MagpieModular/Dodeca/README.md

# Dodeca
An Open Hardware, DIY Eurorack extensible platform allowing the configuration of custom MIDI outputs.

The Dodeca can be chained together with other Dodeca boards. The
typical configuration is the Dubldeca, which is two Dodeca boards
configured in a left and right arrangement, as used by the
[Octatrack 2x Setup Firmware](Octatrack 2x Setup).

# PCBs and panels

Available from Magpie Modular:
- [Dodeca PCB](https://magpie-modular.myshopify.com/products/dodeca)
- [Dubldeca PCBs](https://magpie-modular.myshopify.com/products/dodecca-dubldeca-pcbs)
- [Dubldeca Panel](https://magpie-modular.myshopify.com/products/magpie-modular-dubledeca)

# Build resources

This repository contains the [Build Guide](Build Guide/Build Guide.pdf) and [Hardware Resources](Hardware)

Components for the Dodeca can be ordered from Mouser using [this cart](https://ca.mouser.com/ProjectManager/ProjectDetail.aspx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)

There is also a [Muffwiggler Build Thread](https://www.muffwiggler.com/forum/viewtopic.php?t=188619&highlight=).
