MagpieModular/Dodeca/DODECA_MOUSER_BOM.xlsx

DODECA
Mouser # | Mfr. # | Alternate | Qty. |  | Package | Description |  | Price (USD) | Ext.: (USD) | Links
512-BAT54S | BAT54S |  | 1 | BAT54S | SOT-23 | Schottky Diodes & Rectifiers 30V 200mA | Product Page (http://www.mouser.com/Search/ProductDetail.aspx?R=512-BAT54S) | $0.20 | $0.20
859-6N137 | 6N137 |  | 1 | 6N137 | DIP-8 | High Speed Optocouplers High Speed 10MBd LogicGate Output | Product Page (http://www.mouser.com/Search/ProductDetail.aspx?R=859-6N137) | $0.49 | $0.49
595-TL074IDR | TL074IDR |  | 3 | TL074 | SOIC-14 | Operational Amplifiers - Op Amps Quad Low-Noise JFET-Input | Product Page (http://www.mouser.com/Search/ProductDetail.aspx?R=595-TL074IDR) | $0.82 | $2.46
512-MB1S | MB1S |  | 1 | MB1S | SOIC-4 | Bridge Rectifiers 0.5A Bridge | Product Page (http://www.mouser.com/Search/ProductDetail.aspx?R=512-MB1S) | $0.38 | $0.38
71-CRCW0805-220-E3 | CRCW0805220RFKEA | 603-RC0805FR-07220RL | 1 | 220R | 0805 SMD | Thick Film Resistors - SMD 1/8watt 220ohms 1% 100ppm | Product Page (http://www.mouser.com/Search/ProductDetail.aspx?R=71-CRCW0805-220-E3) | $0.10 | $0.10
660-RK73H2ATTD1692F | RK73H2ATTD1692F |  | 3 | 16.9K | 0805 SMD | Thick Film Resistors - SMD 1/4W 16.9K OHM 1% | Product Page (http://www.mouser.com/Search/ProductDetail.aspx?R=660-RK73H2ATTD1692F) | $0.11 | $0.33
660-RK73H2ATTD2002F | RK73H2ATTD2002F | 603-RC0805FR-0720KL | 9 | 20K | 0805 SMD | Thick Film Resistors - SMD 1/4watts 20Kohms 1% | Product Page (http://www.mouser.com/Search/ProductDetail.aspx?R=660-RK73H2ATTD2002F) | $0.11 | $0.99
603-RC0805FR-0710KL | RC0805FR-0710KL |  | 25 | 10K | 0805 SMD | Thick Film Resistors - SMD 10K OHM 1% | Product Page (http://www.mouser.com/Search/ProductDetail.aspx?R=603-RC0805FR-0710KL) | $0.02 | $0.40
603-RC0805FR-071KL | RC0805FR-071KL |  | 12 | 1K | 0805 SMD | Thick Film Resistors - SMD 1K OHM 1% | Product Page (http://www.mouser.com/Search/ProductDetail.aspx?R=603-RC0805FR-071KL) | $0.02 | $0.19
652-3296W-1-502LF | 3296W-1-502LF | 81-PV36W502C01B00 | 3 | 5K trimmer | 0805 SMD | Trimmer Resistors - Through Hole 3/8" 5Kohms Sealed Vertical Adjust | Product Page (http://www.mouser.com/Search/ProductDetail.aspx?R=652-3296W-1-502LF) | $2.41 | $7.23
581-0805YA471KAT2A | 0805YA471KAT2A |  | 12 | 470pF | 0805 SMD | Multilayer Ceramic Capacitors MLCC - SMD/SMT 16V 470pF C0G 0805 10% Tol | Product Page (http://www.mouser.com/Search/ProductDetail.aspx?R=581-0805YA471KAT2A) | $0.08 | $0.96
81-GRM40X103K50D | GRM216R71H103KA01D |  | 11 | 10nF / 0.01uF | 0805 SMD | Multilayer Ceramic Capacitors MLCC - SMD/SMT 0805 0.01uF 50volts X7R 10% | Product Page (http://www.mouser.com/Search/ProductDetail.aspx?R=81-GRM40X103K50D) | $0.02 | $0.18
81-GRM40X104K50L | GRM21BR71H104KA01L |  | 7 | 100nF / 0.1uF | 0805 SMD | Multilayer Ceramic Capacitors MLCC - SMD/SMT 0805 0.1uF 50volts X7R 10% | Product Page (http://www.mouser.com/Search/ProductDetail.aspx?R=81-GRM40X104K50L) | $0.17 | $1.19
647-ULD1V470MED1TD | ULD1V470MED1TD |  | 3 | 47uF Electrolytic | Radial | Aluminum Electrolytic Capacitors - Leaded 35V 47UF 20% | Product Page (http://www.mouser.com/Search/ProductDetail.aspx?R=647-ULD1V470MED1TD) | $0.16 | $0.48
80-EXV106M025A9BAA | EXV106M025A9BAA |  | 5 | 10uF Electrolytic | Radial | Aluminum Electrolytic Capacitors - SMD 25volts 10uF 20% | Product Page (http://www.mouser.com/Search/ProductDetail.aspx?R=80-EXV106M025A9BAA) | $0.35 | $1.75
875-MI1210K600R-10 | MI1210K600R-10 |  | 3 | Ferrite | 1210 | Ferrite Beads 60ohms 100MHz 1.5A Monolithic 1210 SMD | Product Page (http://www.mouser.com/Search/ProductDetail.aspx?R=875-MI1210K600R-10) | $0.25 | $0.75
78-1N4148WS-E3-08 | 1N4148WS-E3-08 |  | 1 | 1N4148 | SOD-323-2 | Diodes - General Purpose, Power, Switching 100 Volt 350mA | Product Page (http://www.mouser.com/Search/ProductDetail.aspx?R=78-1N4148WS-E3-08) | $0.24 | $0.24
512-LM7805CT | LM7805CT |  | 1 | LM7805 | TO-220-3 | Linear Voltage Regulators 1A Pos Vol Reg | Product Page (http://www.mouser.com/Search/ProductDetail.aspx?R=512-LM7805CT) | $0.95 | $0.95
604-WP914IDT | WP914IDT |  | 12 | Red LEDS - flat | 3mm x 2mm | Standard LEDs - Through Hole Red 625nm Diffused 8mcd 2v | Product Page (http://www.mouser.com/Search/ProductDetail.aspx?R=604-WP914IDT) | $0.13 | $1.58
604-WP914EDT | WP914EDT |  | 0 | Orange LEDS - flat | 3mm x 2mm | Standard LEDs - Through Hole Orange 625nm Diffused 8mcd 2v | Product Page (http://www.mouser.com/Search/ProductDetail.aspx?R=604-WP914EDT) | $0.13 | $1.58
604-WP914GDT | WP914GDT |  | 0 | Green LEDS - flat | 3mm x 2mm | Standard LEDs - Through Hole Green 568nm Diffused 6mcd 2.2v | Product Page (http://www.mouser.com/Search/ProductDetail.aspx?R=604-WP914GDT) | $0.13 | $1.58
161-3402-E | 161-3402-E | 806-STPX-3501-3N | 1 | MIDI - Stereo Jack |  | Phone Connectors PHONE 3.5MM STEREO | Product Page (http://www.mouser.com/Search/ProductDetail.aspx?R=161-3402-E) | $0.93 | $0.93
571-3828118 | 382811-8 |  | 1 | Jumper |  | Headers & Wire Housings ECONOMY SHUNT ASSY | Product Page (http://www.mouser.com/Search/ProductDetail.aspx?R=571-3828118) | $0.17 | $0.17
538-15-91-0140 | 15-91-0140 |  | 1 | 14 pin SMD header |  | Headers & Wire Housings 14 CKT VERT SMT HDR | Product Page (http://www.mouser.com/Search/ProductDetail.aspx?R=538-15-91-0140) | $1.25 | $1.25
855-M20-7820542 | M20-7820542 |  | 1 | 5 pin socket |  | Headers & Wire Housings 5 PIN SIL VERTICAL SOCKET GOLD+TIN | Product Page (http://www.mouser.com/Search/ProductDetail.aspx?R=855-M20-7820542) | $0.89 | $0.89
855-M20-7820442 | M20-7820442 |  | 1 | 4 pin socket |  | Headers & Wire Housings 4 PIN SIL VERTICAL SOCKET GOLD+TIN | Product Page (http://www.mouser.com/Search/ProductDetail.aspx?R=855-M20-7820442) | $0.81 | $0.81
855-M20-7820342 | M20-7820342 |  | 1 | 3 pin socket |  | Headers & Wire Housings 3 PIN SIL VERTICAL SOCKET GOLD+TIN | Product Page (http://www.mouser.com/Search/ProductDetail.aspx?R=855-M20-7820342) | $0.75 | $0.75
855-M20-9993245 | M20-9993245 |  | 2 | 32 pin header |  | Headers & Wire Housings 32 SIL VERTICAL PIN HEADER GOLD HT | Product Page (http://www.mouser.com/Search/ProductDetail.aspx?R=855-M20-9993245) | $1.10 | $2.20
517-929870-01-07-RA | 929870-01-07-RA |  | 4 | 7 pin socket |  | Headers & Wire Housings 7P BRD MNT SKT GOLD 1 ROW 10MICRO" AU | Product Page (http://www.mouser.com/Search/ProductDetail.aspx?R=517-929870-01-07-RA) | $1.24 | $4.96
 |  |  | 1 |  |  | Teensy https://store.oshpark.com/products/teensy-3-1 |  | $17.00 | $17.00
 |  |  | 12 |  |  | Thonkiconn Jacks (PJ301M-12) |  | $0.27 | $3.24 | https://www.thonk.co.uk/shop/3-5mm-jacks/
 |  |  |  |  |  |  |  |  |  | https://erthenvar.myshopify.com/collections/accessories/products/3-5mm-inline-jacks
 |  |  | 1 |  |  | MIDI to stereo cable |  |  |  | https://www.amazon.com/DIN-Male-Playing-Electronic-Musical-Instrument/dp/B01KTFW7S8
 |  |  | 1 |  |  | 10 pin euro power header
 |  |  |  |  |  |  |  | Est Total Cost: | $56.21
