MagpieModular/Dodeca/Hardware/Panels.pdf

T2

T3

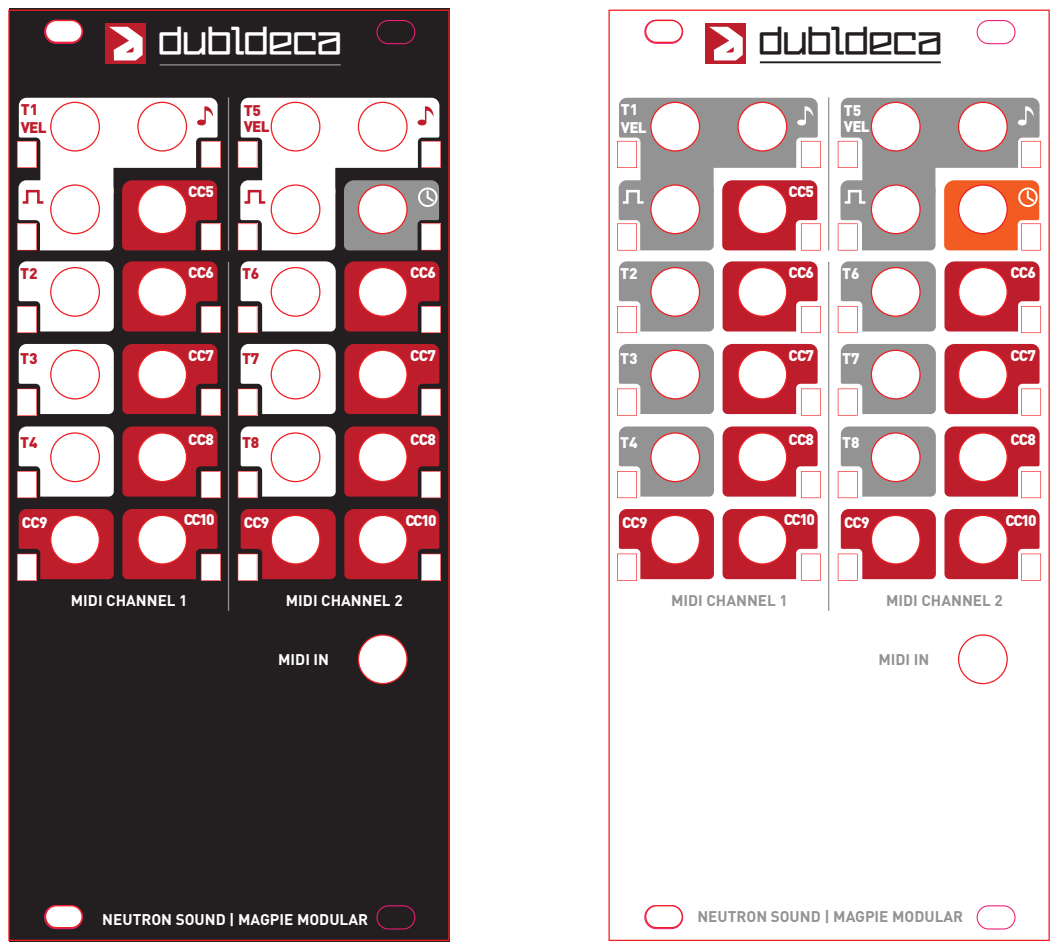
[picture p33: page 1]
MIDI CHANNEL 1; MIDI CHANNEL 2; MIDI IN; dubldeca; VEL

NEUTRON SOUND | MAGPIE MODULAR
