MagpieModular/Dodeca/Software/Octatrack 2x Setup/dubldecca_left/MIDI_CLOCK_handlers.ino

//void HandleClock(void){
//  if (playing){
//  pulses ++;
//  if (pulses > 5){
//    pulses = 0;
//    sixteenthnotes ++;
//  }
//  if (pulses < 3){
//    analogWrite(out2pin[11],127);
//  }
//   else analogWrite(out2pin[11],0);
//}
//}
//
// void HandleStart(){
//  pulses = 0;
//  sixteenthnotes = 0;
//  playing = 1;    
//  }
//  
// void HandleStop(){
//  playing = 0; //remove this to have continuous clock pulses on dodeca after sequencer is stopped
//  digitalWriteFast(out2pin[11],LOW);  //turn pulse off when stopped even if it is in the middle of "on" cycle
//  }
//
//  
//  void HandleContinue(){
//    //maybe only needed for song position pointer
//  }
