MagpieModular/Dodeca/Software/Octatrack 2x Setup/dubldecca_left/MIDI_Note_CC_handlers.ino

void HandleNoteOn(byte channel, byte pitch, byte velocity) {
  if (channel == CHANA) {
    int modNote = (whitekeys[pitch % 12] ) ;
    if (velocity != 0) {
      if (modNote) {
        analogWrite(out2pin[modNote], velocity);
      }     
    }
    else bothNoteOff(channel, pitch, velocity);
  }
  if (channel == CHANB) {

    if (velocity != 0) {

      analogWrite(out2pin[0], velocity);
      analogWrite(A14, pitch);
      analogWrite(out2pin[2], 127);
    }
    else bothNoteOff(channel, pitch, velocity);
  }
}

void HandleNoteOff(byte channel, byte pitch, byte velocity) {
  bothNoteOff(channel, pitch, velocity);
}

void bothNoteOff(byte channel, byte pitch, byte velocity) { //this is called by handle noteoff and note on when velocity = 0
  if (channel == CHANA) {
    int modNote = (whitekeys[pitch % 12] ) ;
    if (modNote) {
      analogWrite(out2pin[modNote], 0);
    }
  }
  if (channel == CHANB) {
    //analogWrite(out2pin[0], 0);
    analogWrite(out2pin[2], 0);
  }
}


void HandleControlChange (byte channel, byte number, byte value) {
  if (channel == CHANA) {

    for (int i = 0; i < 6; i ++) {
      if ( number  == cc2active[i]) { //ignore wrong channel or CC numbers
        analogWrite(out2pin[cc2out[i]], value);
      }
    }
  }
}
